CircuitCo/BeagleBoard-xM-LCD7-RevB/BeagleBoard-XM-LCD7-RevB-bom.xls

COVER PAGE Revised: Tuesday, September 04, 2012
BB-xM-LCD7-01 Revision: B
ITM | QTY | REF DESIGNATIORS | PART | PCB FOOTPRINT | DESCRIPTION | MAN | PART # | Comments
1 | 1 | PCB1 | BB-xM-LCD7-PCB-01 |  | PCB, 4 Layer 4.5" x 6.9 " |  | BB-xM-LCD7-PCB-01
2 | 2 | C2,C4 | 22uF, 25v | c1206-40x70 | CAP CER 22UF 25V X5R 1206 |  | GRM31CR61E226KE15L
3 | 1 | C3 | 6.8pF, 50v | c402-25 | CAP CER 6.8PF 50V C0G 0402 |  | GRM1555C1H6R8DZ01D
4 | 1 | C5 | 1nF, 25v | c402-25 | CAP CER 1000PF 50V 10% X7R 0402 |  | GRM155R71H102KA01D
5 | 1 | C6 | 2.2nF | c402-25 | CAP CER 2200PF 50V 10% X7R 0402 |  | GRM155R71H222KA01D
6 | 5 | C7,C8,C9,C11,C94 | 0.22uF | c603-35x45 | CAP CER .22UF 50V Y5V 0603 |  | GRM188F51H224ZA01D
7 | 3 | C10,C12,C41 | 1uF, 10v | c603-35x45 | CAP CER 1.0UF 25V X5R 0603 |  | TMK107BJ105KA-T
8 | 2 | C13,C22 | 4.7uF | c603-35x45 | CAP CER 4.7UF 6.3V X5R 0603 |  | GRM188R60J475ME19D
9 | 27 | C14,C15,C16,C17,C18,C19,C20,C21,C23,C25,C26,C27,C28,C29,C30,C31,C32,C33,C34,C35,C40,C42,C43,C45,C46,C47,C93 | 0.1uF | c402-25 | Capacitor 0.1uF 16V 10% 0402 X7R | Kemet | C0402C104K4RACT
10 | 2 | C48,C49 | 4.7uF, 25V | c805-35x60 | CAP CER 4.7UF 50V X5R 10% 0805 |  | C2012X5R1H475K
11 | 1 | D1 | MBRM120L | powermite-case457-04 | DIODE SCHOTTKY 20V 1A POWERMITE |  | MBRM120LT3G
12 | 1 | D2 | BAT54S/SOT | sot23-28x44 | DIODE SCHOTTKY DUAL 30V SOT323 |  | BAT54SWT1G
13 | 1 | D3 | LTST-C190GKT | led2-31sq | LED GREEN CLEAR 0603 SMD |  | LTST-C190GKT
14 | 1 | J1 | HEADER 14X2 | jump2x14-6040-1 | CONN HDR PLUG VERT 28POS .100 |  | 67997-428HLF
15 | 2 | J3,J4 | HEADER 10X2_0 | ftsh2x10-4528 | MICRO SOCKET STRIP CENTERLINE: .050"(1,27MM) |  | FTSH-110-01-F-D
16 | 2 | L1,L2 | LPO6610-332M | ind-lqh32m | INDUCTOR 4.7UH 20% 450MA 1210 |  | LQH32CN4R7M23L
17 | 1 | P1 | CONN_PWR1_2.5MM | CONN3-PWR-PJ102A | CONN POWER JACK 2.1MM |  | PJ-002A
18 | 2 | P2,P10 | EXP_HDR_28 | jump2x14-6040 | CONN HDR RECPT VERT 28POS .100 |  | LSWSS-114-D-02-T-LF
19 | 1 | P3 | FH28-60S-0.5SH | conn-fh28-60s | CONN 60POS FPC 0.5MM SMD GOLD |  | FH28-60S-0.5SH(05)
20 | 1 | P6 | TOUCHSCREEN CONNECTOR | conn4-24x79-sfw | Conn FFC/FPC Connector SKT 4 POS 1mm Solder RA |  | SFW4R-1ST
21 | 1 | P7 | SM02B-BHSS-1 | con2-bhs-jst | 2 Position 3.5mm Pitch Wire to Board Disconnectable Socket | JST | SM02B-BHSS-1-TB(LF)
22 | 1 | Q3 | BSS138 | SOT23-3 | MOSFET Nchan 50V 200mA | Diodes Inc. | BSS138-7-F
23 | 1 | Q7 | FMMT458/SOT | sot23-28x44-bec | TRANS HP NPN 400V 225MA SOT23-3 |  | FMMT458TA
24 | 4 | RP1,RP2,RP3,RP4 | EXB2HV330J | rpak16-10x25-2hv | RES ARRAY 33 OHM 5% 8 RES SMD |  | EXB2HV330J
25 | 1 | R6 | 500K | c402-25 | RES 499K OHM 1/16W 1% 0402 SMD |  | ERJ-2RKF4993X
26 | 1 | R8 | 430K | c402-25 | RES 430K OHM 1/16W 1% 0402 SMD |  | ERJ-2RKF4303X
27 | 1 | R9 | 330K | c402-25 | RES 330K OHM 1/16W 1% 0402 SMD |  | ERJ-2RKF3303X
28 | 1 | R10 | 15K | c402-25 | RES 15K OHM 1/16W 1% 0402 SMD |  | ERJ-2RKF1502X
29 | 2 | R11,R15 | 56K | c402-25 | RES 56K OHM 1/16W 1% 0402 SMD |  | ERJ-2RKF5602X
30 | 1 | R12 | 750K | c402-25 | RES 750K OHM 1/16W 1% 0402 SMD |  | ERJ-2RKF7503X
31 | 1 | R13 | 680K | c402-25 | RES 680K OHM 1/16W 1% 0402 SMD |  | ERJ-2RKF6803X
32 | 1 | R14 | 130K | c402-25 | RES 130K OHM 1/16W 1% 0402 SMD |  | ERJ-2RKF1303X
33 | 12 | R16,R139,R148,R44,R62,R67,R68,R69,R70,R71,R72,R73 | 10K | c402-25 | Resistor 10Kohm 1/16W 5% 0402 | Rohm | MCR01MZPJ103
34 | 2 | R45,R55 | 62 | r402-25 | RES 62 OHM 1/16W 1% 0402 SMD |  | ERJ-2RKF62R0X
35 | 1 | R46 | 196 | r402-25 | RES 196 OHM 1/16W 1% 0402 SMD |  | ERJ-2RKF1960X
36 | 1 | R47 | 69.8 | r402-25 | RES 69.8 OHM 1/16W 1% 0402 SMD |  | ERJ-2RKF69R8X
37 | 1 | R48 | 40.2 | r402-25 | RES 40.2 OHM 1/16W 1% 0402 SMD |  | ERJ-2RKF40R2X
38 | 1 | R49 | 237 | r402-25 | RES 237 OHM 1/16W 1% 0402 SMD |  | ERJ-2RKF2370X
39 | 1 | R50 | 24.9 | r402-25 | RES 24.9 OHM 1/16W 1% 0402 SMD |  | ERJ-2RKF24R9X
40 | 1 | R51 | 165 | r402-25 | RES 165 OHM 1/16W 1% 0402 SMD |  | ERJ-2RKF1650X
41 | 1 | R52 | 64.9 | r402-25 | RES 64.9 OHM 1/16W 1% 0402 SMD |  | ERJ-2RKF64R9X
42 | 1 | R53 | 82 | r402-25 | RES 82 OHM 1/16W 1% 0402 SMD |  | ERJ-2RKF82R0X
43 | 1 | R54 | 240 | r402-25 | RES 240 OHM 1/16W 1% 0402 SMD |  | ERJ-2RKF2400X
44 | 4 | R56,R57,R58,R150 | 4.7K | r402-25 | RES 4.75K OHM 1/16W 1% 0402 SMD | Stackpole Electronics | RMCF0402FT4K75
45 | 8 | R63,R64,R65,R66,R78,R80,R97,R98 | 0 | r402-25 | Resistor Zero ohm Jumper 0402 | Yageo | RC0402JR-070RL
46 | 1 | R74 | 330 | r402-25 | RES 330 OHM 1/10W 5% 0402 SMD |  | CRCW0402330RJNED
47 | 1 | R75 | 2E | 603 | RES 2.00 OHM 1/16W 1% 0603 SMD | Yaego | RC0603FR-072RL
48 | 1 | R79 | 2K | r402-25 | RES 2K OHM 1/16W 1% 0402 SMD |  | ERJ-2RKF2001X
49 | 1 | R96 | 71.5K | c402-25 | RES 71.5K OHM 1/16W 1% 0402 SMD |  | ERJ-2RKF7152X
50 | 1 | R102 | 10R | c402-25 | RES 10.0 OHM 1/16W 1% 0402 SMD | Yaego | RC0402FR-0710RL
51 | 1 | S1 | KT11P2JM | sw4-b3f-315x | SWITCH TACTILE SPST-NO 0.05A 24V, RA | Omron | B3F-3100
52 | 1 | U2 | TPS65105PWP | pwp24-14x70 |  | TI | TPS65105PWPR
53 | 1 | U3 | 74avc8t245 | bga96-ZKE | IC BUS TRANSCVR 32BIT 96BGA | TI | SN74AVC32T245ZKER
54 | 1 | U4 | AT24C01B | so8-25x75 |  |  | AT24C01B
55 | 1 | U5 | TSC2007IPW | pw16-14x70 |  |  | TSC2007IPW
56 | 1 | U7 | TXS0102DCU | DCU8-10X50 |  |  | TXS0102DCU
57 | 1 | U8 | TLC59108IPW | pw20-14x70 |  |  | TLC59108IPW
58 | 1 | U9 | TPS61080DRC | drc10-11x33 |  |  | TPS61080DRC
59 | 1 | U10 | SN74LVC1G07DCK | SC-70 |  |  | SN74LVC1G07DCK
60 | 1 | U11 | SN74LVC1G06DCK | DCK5 |  |  | SN74LVC1G06DCK
61 | 1 | LCD1 |  |  | LCD TFT WVGA RGB | ThreeFiveCorp | TFC-S9700RTWV43-01B
62 | 40 | C44,C50,C24,R59,R60,R61,R76,R77,R82,R95,R99,R100,R101,R151,U6,TP1,TP2,TP3,S2,S3,S4,S5,S6,U12,R83,R84,R85,R86,R87,R88,R89,R90,R81,D5,C51,C52,C36,C37,C38,C39 |  |  | DO NOT INSTALL
