CircuitCo/BeagleBoard-xM-LCD7-RevB/BeagleBoard-xM-LCD7-RevB-schematic.pdf

# 6/14/2011 BBT

# DATE

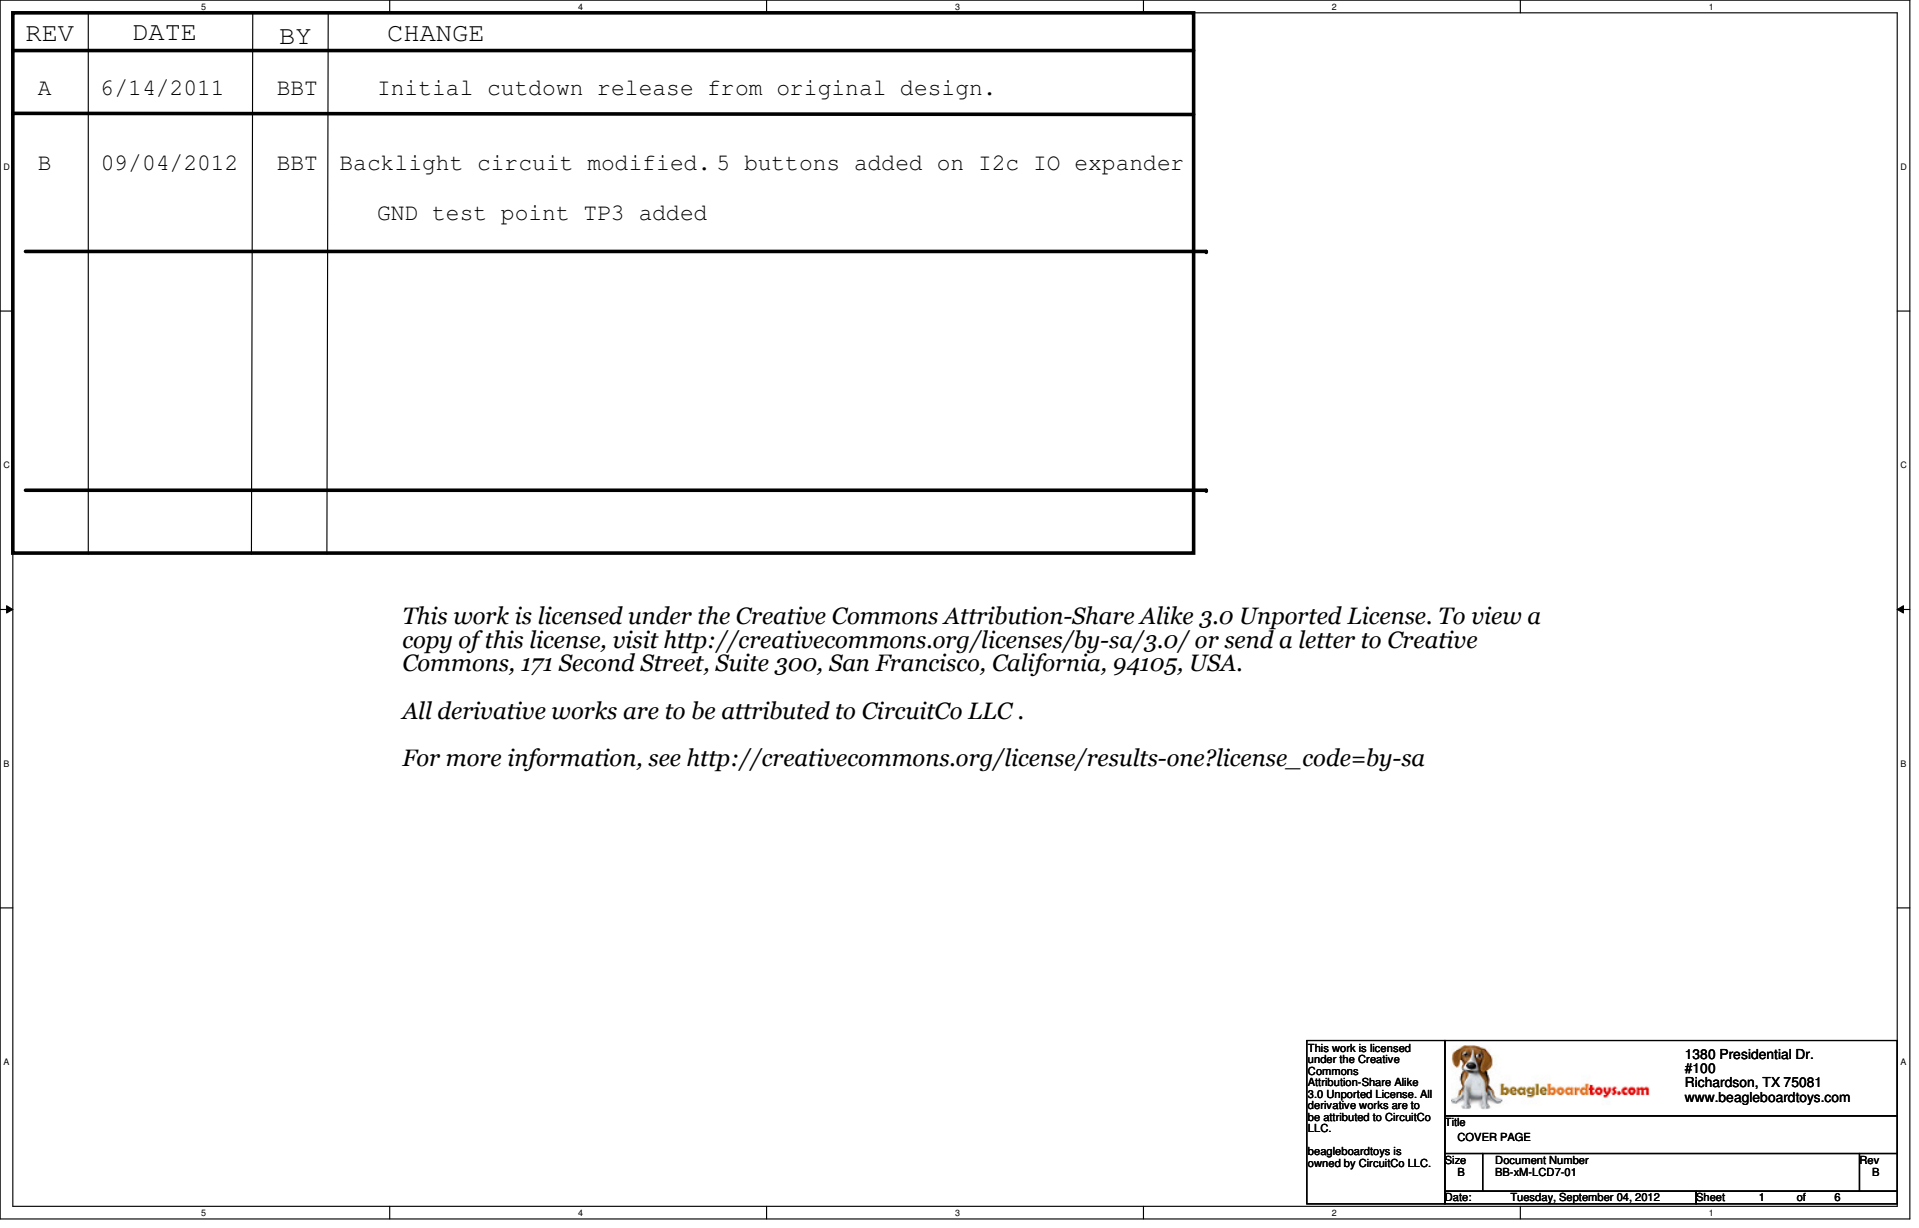
[picture p11: page 1]
REV; CHANGE; Backlight circuit modified. 09/04/2012; BBT; Title; Size; Document Number; Rev; Date:; Sheet; BB-xM-LCD7-01; COVER PAGE; Tuesday, September 04, 2012; Title COVER PAGE

Initial cutdown release from original design.

5 buttons added on I2c IO expander

GND test point TP3 added

This work is licensed under the Creative Commons Attribution-Share Alike 3.0 Unported License. To view a
copy of this license, visit http://creativecommons.org/licenses/by-sa/3.0/ or send a letter to Creative
Commons, 171 Second Street, Suite 300, San Francisco, California, 94105, USA.

All derivative works are to be attributed to CircuitCo LLC .

For more information, see http://creativecommons.org/license/results-one?license_code=by-sa

This work is licensed
under the Creative
Commons
Attribution-Share Alike
3.0 Unported License. All
derivative works are to
be attributed to CircuitCo
LLC.

1380 Presidential Dr.
Richardson, TX 75081
www.beagleboardtoys.com

beagleboardtoys is
owned by CircuitCo LLC.

## Pressing and releasing S1 will

reset the ARM Processor.

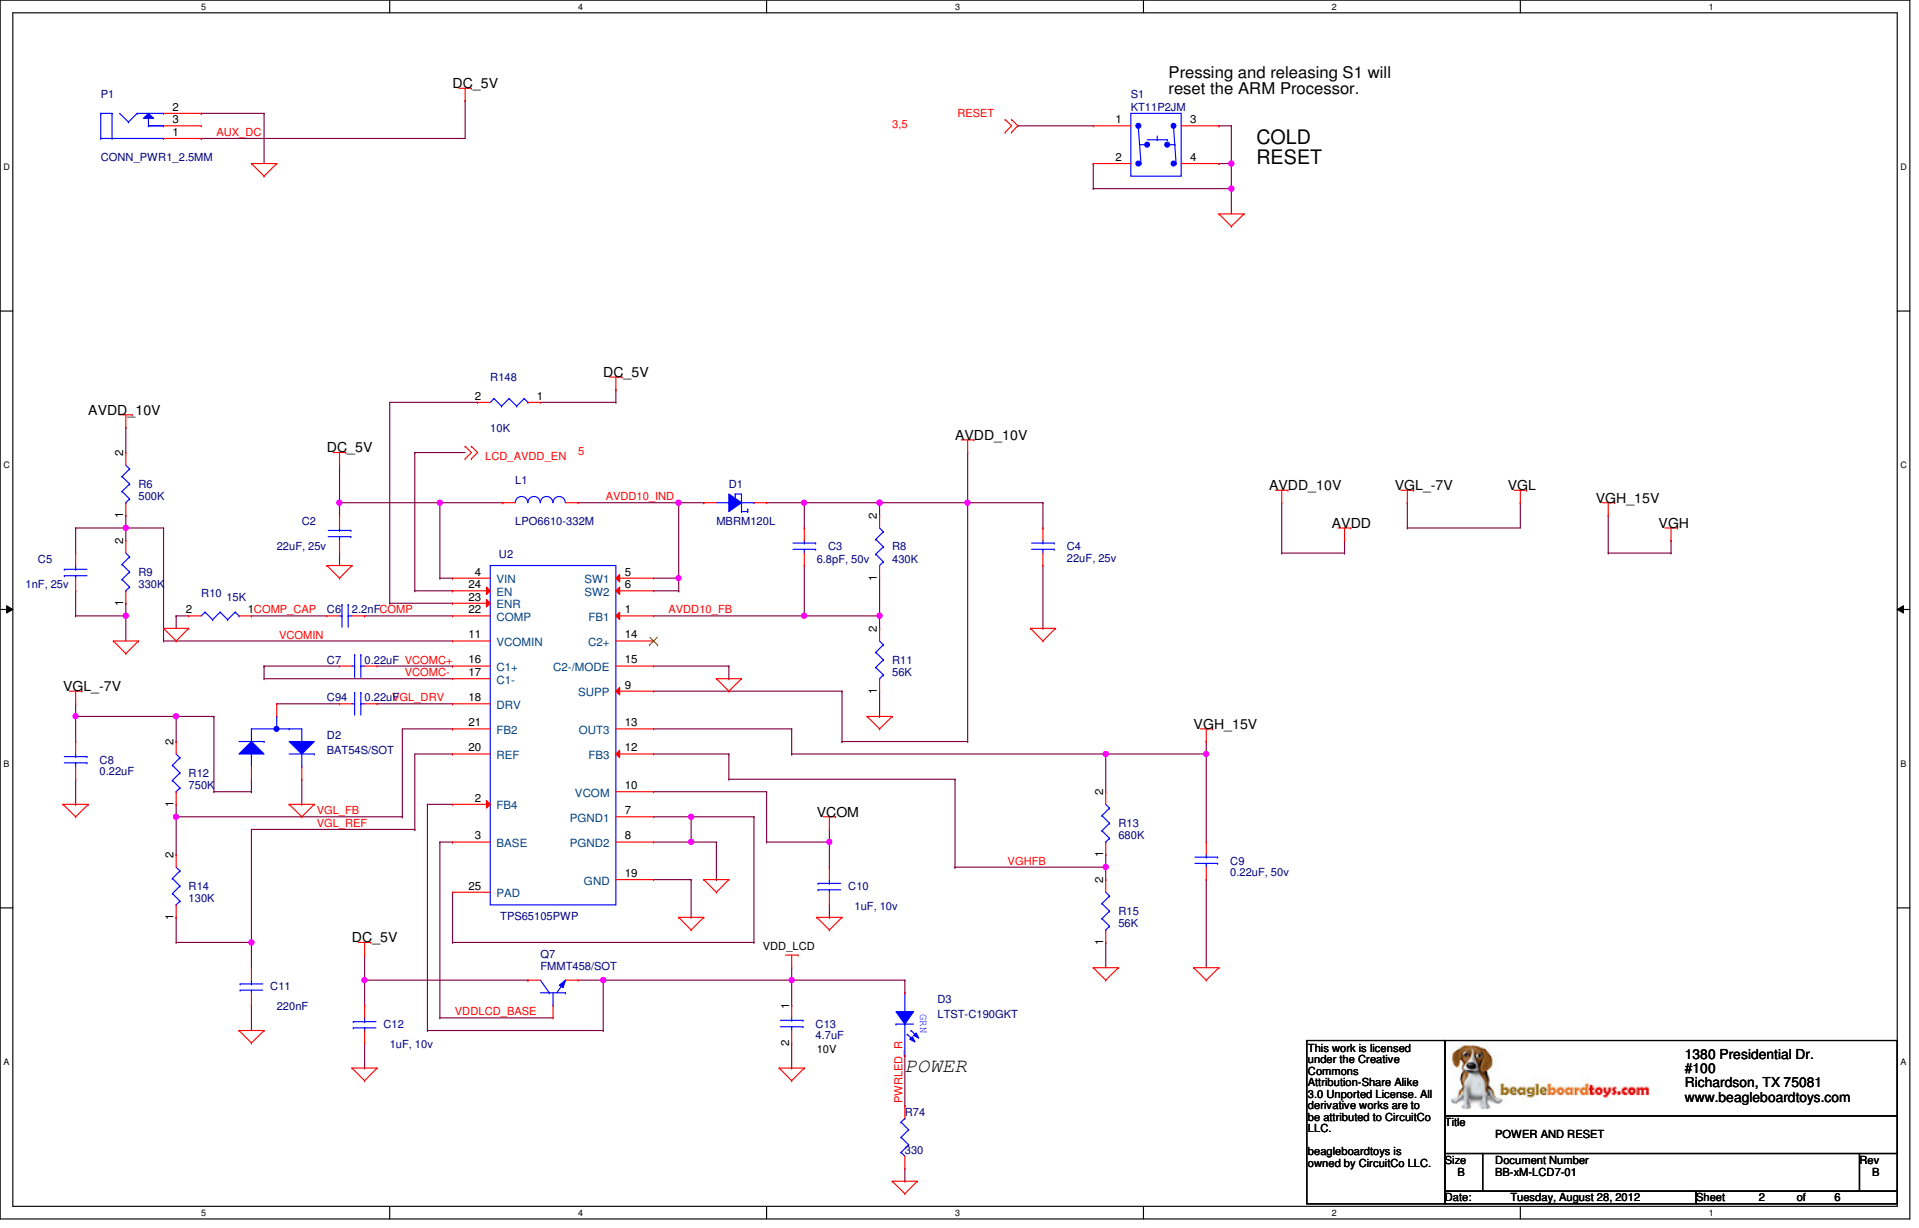
[picture p12: page 2]
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

# Beagle Expansion Connector

# Beagle LCD RGB Interface

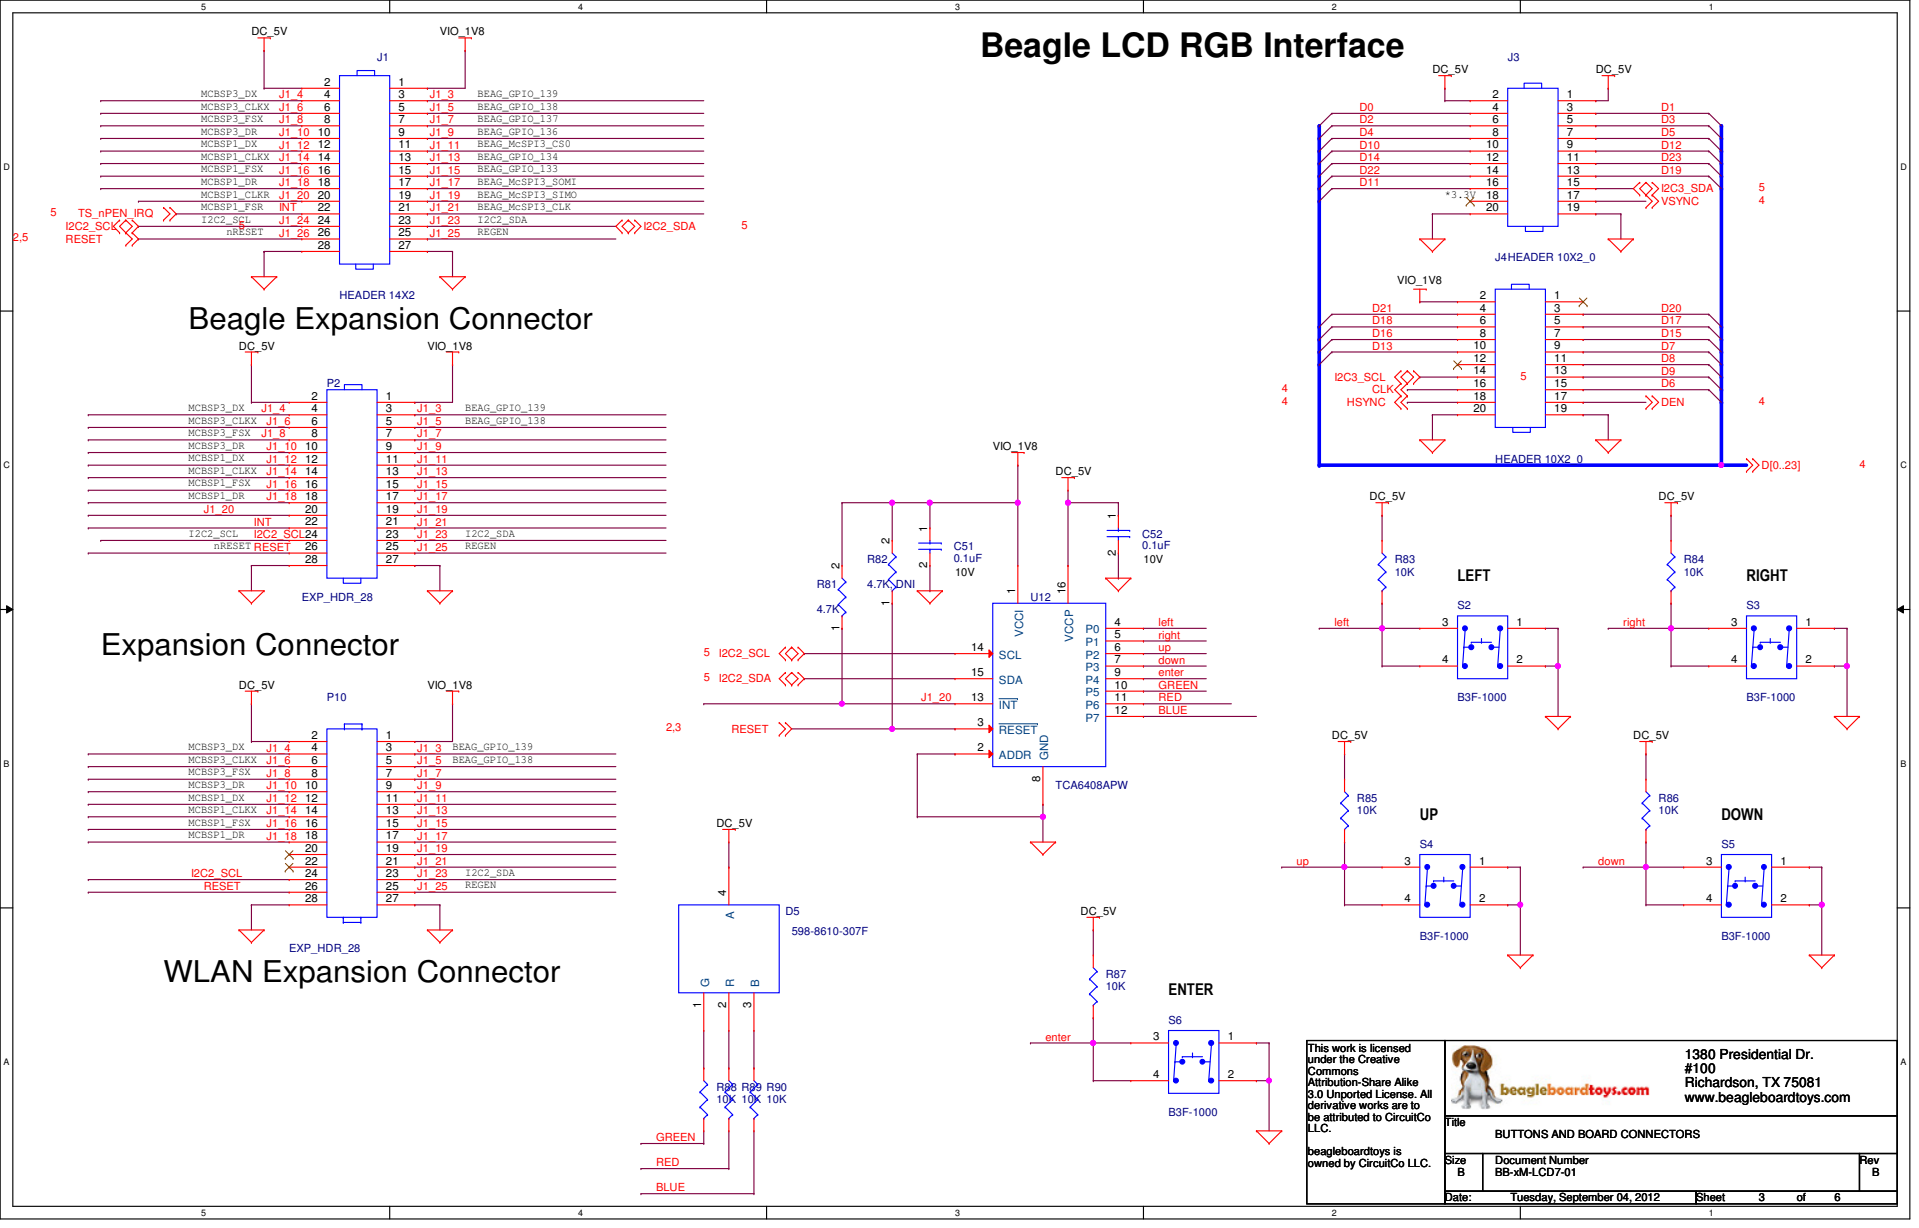
[picture p13: page 3]
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

BUTTONS AND BOARD CONNECTORS

Beagle-xM Buffer | GAMMA CIRCUIT

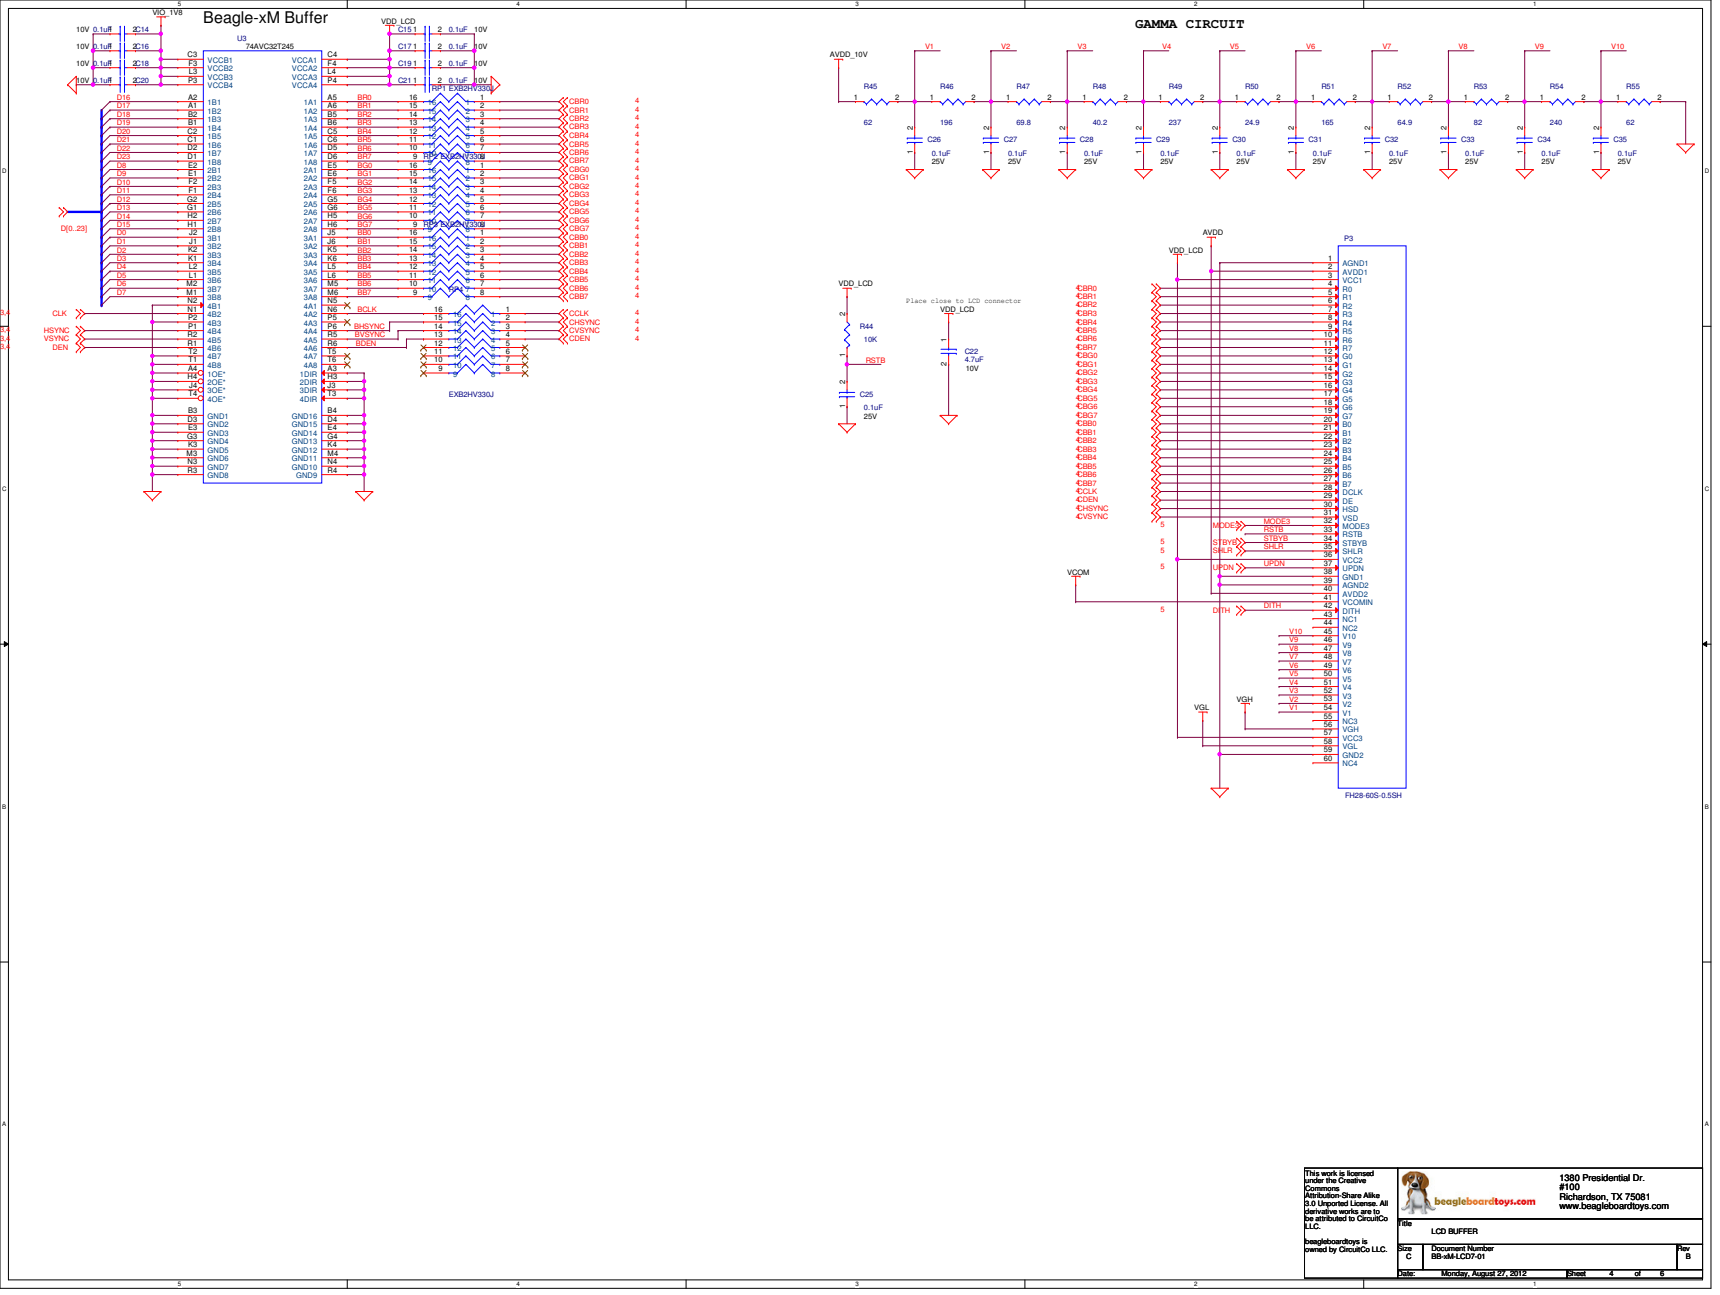
[picture p14: page 4]

Place close to LCD connector

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

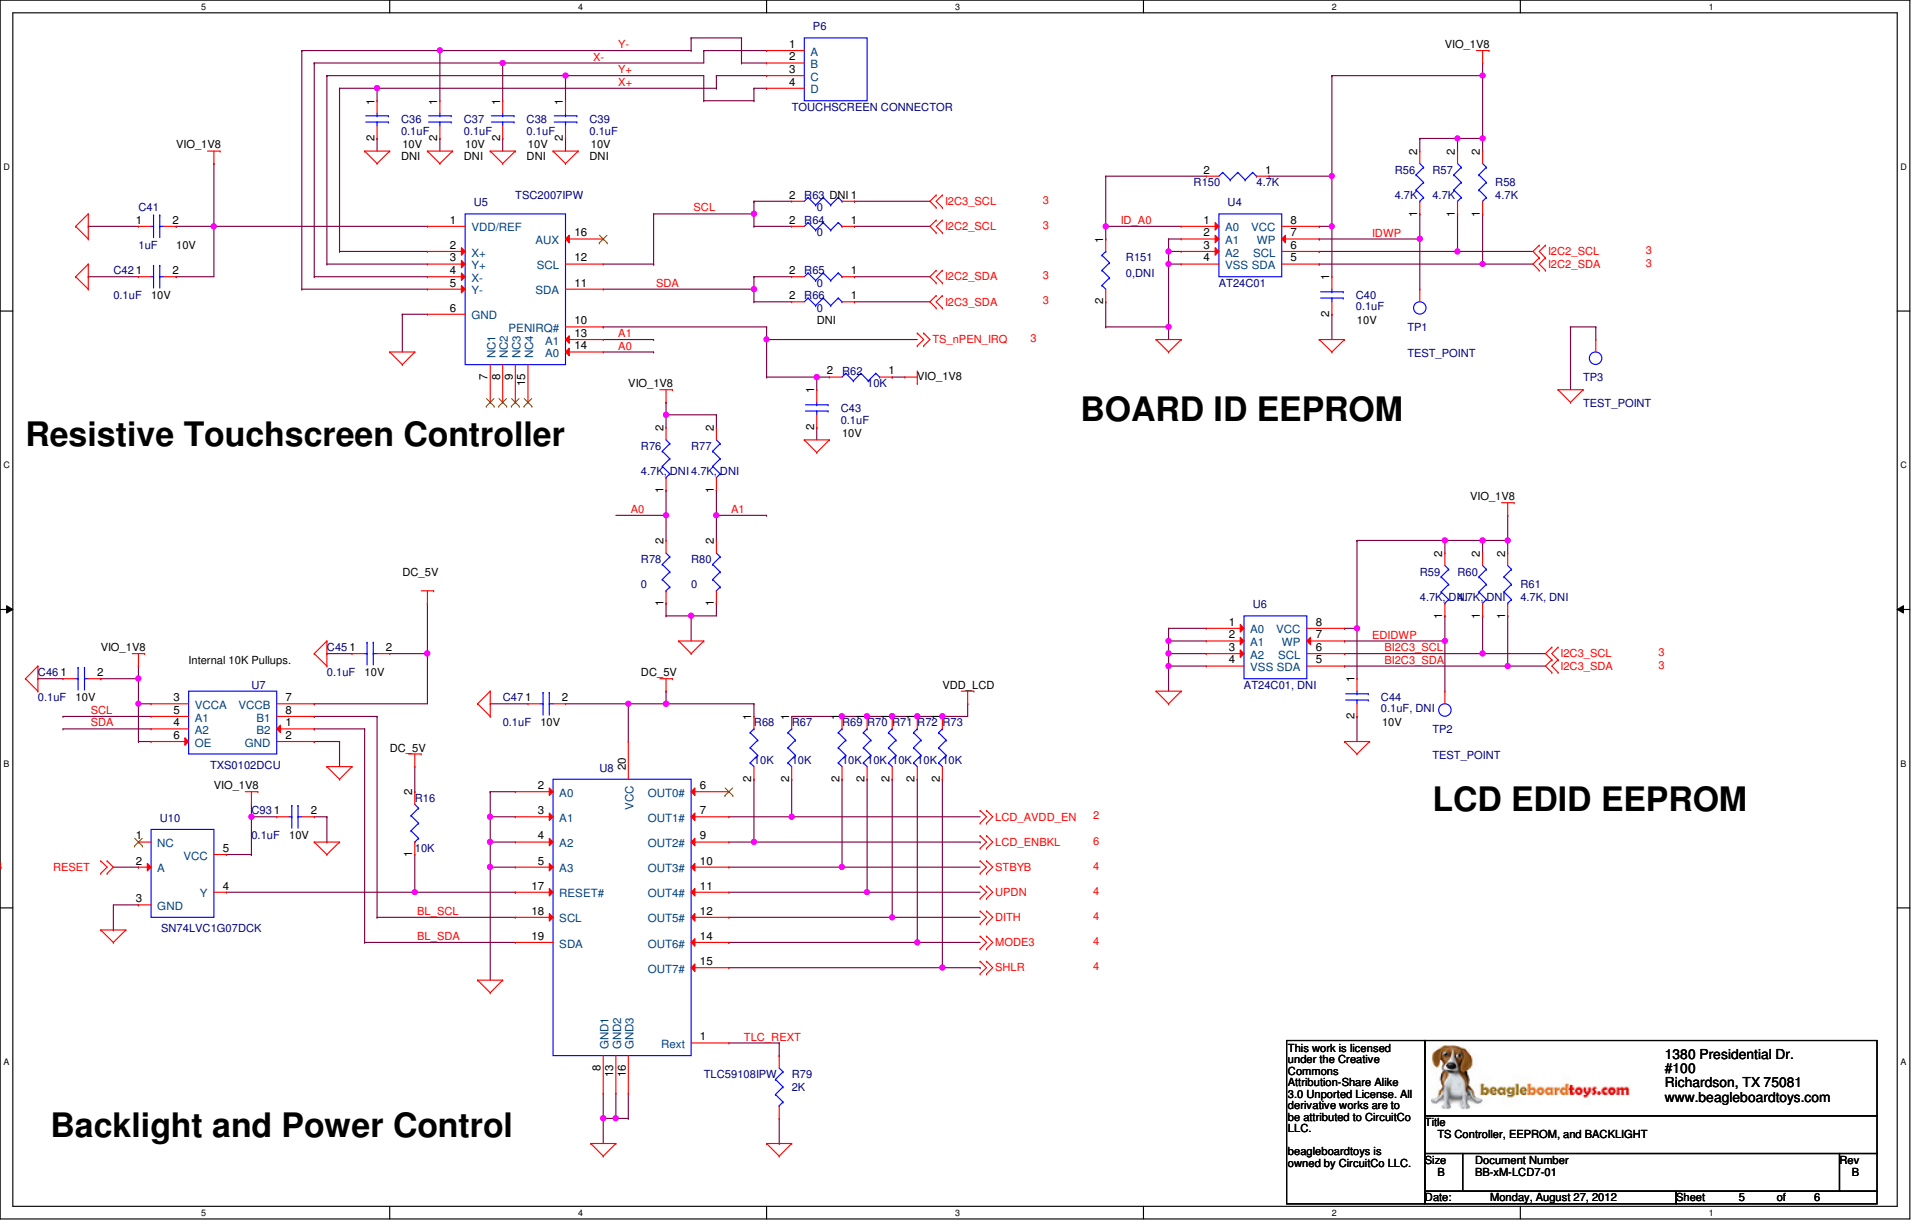
[picture p15: page 5]

Y+
X+

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

Backlight and Power Control

Title
TS Controller, EEPROM, and BACKLIGHT

BL_L | BL_SW

## VDD_5V

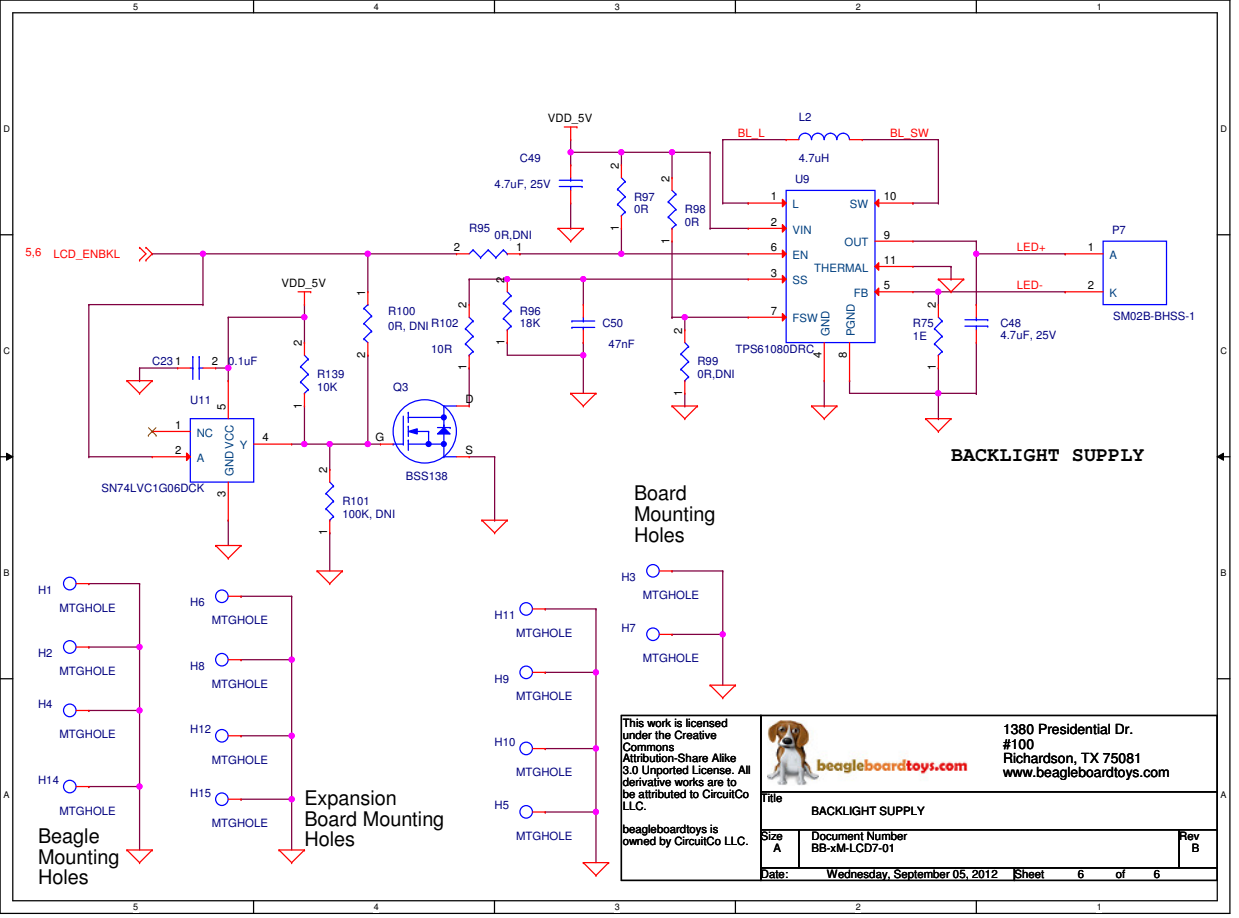
[picture p16: page 6]
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
