CircuitCo/BeagleBoard-xM-LCD7-RevB/(list of files, drawings)

Other design files:
BeagleBoard-xM-LCD7-RevB-schematic.dsn
