CircuitCo/BeagleBoard-xM-LCD7-RevB/(commit log)

2012-12-11 rm bom
    [BeagleBoard-XM-LCD7-RevB-bom.xls]
2012-12-11 add srm bom
    [BeagleBoard-XM-LCD7-RevB-bom.xls]
